Adbo03/Projet_Arduinode/ADXL_SPI.ino

#include <NimBLEDevice.h>
#include <SPI.h>
#include "SdFat.h"
#include <TinyGPS++.h>
#include <math.h>
#include <stdlib.h>
#include <map>
#include <WiFi.h>
#include <WebServer.h>
#include <esp_now.h>
#include <set>

#define ON              1
#define OFF             0

// Paramétrage
#define ADXL_CS         10
#define SD_CS           9 
#define SCK_SD          22
#define MOSI_SD         23
#define MISO_SD         21

#define PPS_PIN         2

// Modes
#define SBY             0
#define LIVE            1
#define RECORD          2
#define WIFI_COLLECT    3

// Plages de mesure
#define _2g             0
#define _4g             1
#define _8g             2

// Frequences d'échantillonnage
#define _4000Hz         0
#define _2000Hz         1
#define _1000Hz         2
#define _500Hz          3
#define _250Hz          4
#define _125Hz          5
#define _62_5Hz         6
#define _31_25Hz        7
#define _15_625Hz       8
#define _7_813Hz        9
#define _3_906Hz        10

// Types de messages ESP NOW
#define CMD_PING        0  
#define CMD_CONFIG      1   
#define REPLY_PONG      2  
#define REPLY_ACK       3  

// Tensions batterie
#define V_MAX           4.2 
#define V_MIN           3.0

// Bus SPI dédié pour communiquer avec le lecteur SD
SPIClass sdSPI(HSPI);

struct Sample_SD {
  int32_t x, y, z;
  uint32_t sub_sec_us; // Microsecondes écoulées depuis le dernier front PPS
};

struct Sample_LIVE {
  int32_t x, y, z;
};

// Gestion de la retransmission des modifications BLE (ESP-NOW)
struct __attribute__((packed)) SyncPacket {
  uint32_t msgId;  
  uint8_t type;        
  uint8_t originMac[6];
  uint8_t mode;      
  uint8_t range;     
  uint8_t frequency; 
  uint32_t nodeID;
  uint8_t batteryLevel;
};

SyncPacket pendingConfig;            
uint32_t lastReceivedMsgId = 0;       
volatile bool hasNewConfigFromESPNow = false; 
uint8_t broadcastAddress[] = {0xFF, 0xFF, 0xFF, 0xFF, 0xFF, 0xFF};

std::set<String> discoveredNodes;  
std::set<String> ackedNodes;       
std::set<String> forwardedReplies; 
volatile bool isInitiator = false;

// Buffers 
const int BUF_SIZE_SD = 32;
Sample_SD bufferSD[2][BUF_SIZE_SD];

const int BUF_SIZE_LIVE = 42; 
Sample_LIVE bufferLIVE[3][BUF_SIZE_LIVE];

volatile int activeBuf = 0;
volatile int bufIdx = 0;
volatile bool fullFlag = false;

SdFat sd;
SdFile file;
TinyGPSPlus gps;
hw_timer_t * timerSample = NULL;

WebServer server(80);

const int tabHz[11] = {4000, 2000, 1000, 500, 250, 125, 62.5, 31.25, 15.625, 7.813, 3.906};
volatile uint8_t currentMode = SBY; 
volatile uint8_t currentRange = _2g;
volatile uint8_t currentFreq = _4000Hz;
volatile uint8_t broadcast = ON;

volatile int32_t TICK_SAMPLE_US = 1000000/tabHz[currentFreq];

volatile uint32_t pps_micros = 0;
float lastLat = 0, lastLon = 0;
char hours[3], minutes[3], seconds[3], interval[3], day[3], month[3], year[5];

// Adresses des registres
const int REG_XDATA3 = 0x08;
const int REG_RANGE  = 0x2C;
const int REG_POWER_CTL = 0x2D;
const int REG_FILTER = 0x28;

// Objets et pointeurs BLE 
NimBLEServer* pServer = NULL;
NimBLECharacteristic* pRawDataChar = NULL;
NimBLECharacteristic* pModeChar = NULL;
NimBLECharacteristic* pRangeChar = NULL;
NimBLECharacteristic* pFrequencyChar = NULL;
NimBLECharacteristic* pBroadcastChar = NULL;
NimBLECharacteristic* pSyncChar = NULL;

volatile bool deviceConnected = false;
bool wasConnected = false;
volatile bool modeWritten = false;
volatile bool rangeWritten = false;
volatile bool freqWritten = false;
volatile bool wifiStarted = false;

int32_t x_raw = 0;
int32_t y_raw = 0;
int32_t z_raw = 0;

SemaphoreHandle_t timerSampleFlag;

uint64_t arduinodeID = 0;
String nodeName = "Arduinode_0";

void configureArduinodeID() {
  uint64_t chipID = ESP.getEfuseMac(); 
  Serial.printf("ID: %04X%08X\n", (uint16_t)(chipID >> 32), (uint32_t)chipID);      
  
  // Utilisation de l'adresse MAC pour générer des identifiants uniques
  if (chipID == 0x4886AE63B0E4) { arduinodeID = 0; }
  else if (chipID == 0x98302E43CA48) { arduinodeID = 1; }
  else if (chipID == 0x2C3CA0BD4D74) { arduinodeID = 2; }
  else { 
    arduinodeID = chipID; 
  }
  
  nodeName = "Arduinode_" + String(arduinodeID);
  Serial.print("Module : "); Serial.println(nodeName);
}


/* - - - Fonctions pour gérer la retransmission aux autres arduinodes - - - */

String macToString(const uint8_t* mac) {
  char buf[20];
  snprintf(buf, sizeof(buf), "%02X:%02X:%02X:%02X:%02X:%02X", mac[0], mac[1], mac[2], mac[3], mac[4], mac[5]);
  return String(buf);
}

void OnDataRecv(const uint8_t * mac, const uint8_t *incomingData, int len) {
  if (len == sizeof(SyncPacket)) {
    SyncPacket packet;
    memcpy(&packet, incomingData, sizeof(SyncPacket));
    String originMacStr = macToString(packet.originMac);

    if (packet.type == CMD_PING || packet.type == CMD_CONFIG) {
      if (packet.msgId > lastReceivedMsgId) {
        lastReceivedMsgId = packet.msgId;
        isInitiator = false;      
        forwardedReplies.clear(); 

        if (packet.type == CMD_CONFIG) {
          pendingConfig = packet;
          hasNewConfigFromESPNow = true;
          Serial.println("Nouvelle configuration reçue !");
        } 
        else {  
          esp_now_send(broadcastAddress, (uint8_t *) &packet, sizeof(packet));
        }

        delayMicroseconds(random(2000, 25000));

        SyncPacket reply;
        reply.msgId = packet.msgId;
        reply.type = (packet.type == CMD_PING) ? REPLY_PONG : REPLY_ACK;
        WiFi.macAddress(reply.originMac);
        reply.mode = currentMode;
        reply.range = currentRange;
        reply.frequency = currentFreq;
        reply.nodeID = (uint32_t)arduinodeID;
        reply.batteryLevel = (uint8_t)getBatteryState();

        esp_now_send(broadcastAddress, (uint8_t *) &reply, sizeof(reply));
      }
    }
    
    else if (packet.type == REPLY_PONG || packet.type == REPLY_ACK) {
      if (packet.msgId == lastReceivedMsgId) {
        
        if (isInitiator) {
          if (packet.type == REPLY_PONG) {

            // Pour éviter des envois redondants
            if(discoveredNodes.insert(originMacStr).second){
              struct __attribute__((packed)) NodeStatusBLE {
                uint32_t nodeID;
                uint8_t batteryLevel;
              } remoteNode;

              remoteNode.nodeID = packet.nodeID;
              remoteNode.batteryLevel = packet.batteryLevel;

              pSyncChar->setValue((uint8_t*)&remoteNode, sizeof(remoteNode));
              pSyncChar->notify();
            }

          } 
          else if (packet.type == REPLY_ACK) {
            
            // Pour éviter des envois redondants
            if(ackedNodes.insert(originMacStr).second){
              if (discoveredNodes.size() > 0 && discoveredNodes.size() == ackedNodes.size()) {
                uint8_t successCode = 0xFF;
                pSyncChar->setValue(&successCode, 1);
                pSyncChar->notify();
              }
            }

          }
        }

        if (forwardedReplies.find(originMacStr) == forwardedReplies.end()) {
          forwardedReplies.insert(originMacStr);
          esp_now_send(broadcastAddress, (uint8_t *) &packet, sizeof(packet));
        }
      }
    }
  }
}

void broadcastConfiguration(uint8_t type, uint8_t mode, uint8_t range, uint8_t freq) {
  lastReceivedMsgId++; 
  isInitiator = true; 
  
  if (type == CMD_PING) {
    discoveredNodes.clear();
    ackedNodes.clear();
  } 
  
  else if (type == CMD_CONFIG) {
    ackedNodes.clear();
  }

  forwardedReplies.clear();

  SyncPacket packet;
  packet.msgId = lastReceivedMsgId;
  packet.type = type;
  WiFi.macAddress(packet.originMac);
  packet.mode = mode;
  packet.range = range;
  packet.frequency = freq;

  esp_now_send(broadcastAddress, (uint8_t *) &packet, sizeof(packet));
}

void initEspNow() {
  WiFi.mode(WIFI_STA);

  if (esp_now_init() != ESP_OK) {
    Serial.println("Erreur : echec de l'initialisation de ESP-NOW");
    return;
  }

  esp_now_register_recv_cb(OnDataRecv);

  esp_now_peer_info_t peerInfo;
  memset(&peerInfo, 0, sizeof(peerInfo));
  memcpy(peerInfo.peer_addr, broadcastAddress, 6);
  peerInfo.channel = 0;  // Canal WiFi par défaut
  peerInfo.encrypt = false;
  
  if (esp_now_add_peer(&peerInfo) != ESP_OK){
    Serial.println("Erreur : echec de l'ajout du peer broadcast");
  } else {
    Serial.println("ESP-NOW configuré et prêt pour la communication inter-arduinodes");
  }
}

/* - - - Fonctions callbacks pour gérer les intéractions avec l'IHM BLE - - - */

class MyServerCallbacks: public NimBLEServerCallbacks {
  public:
    void onConnect(NimBLEServer* pServer, NimBLEConnInfo& connInfo){
      deviceConnected = true;
      // Paramètres : Handle, Min Interval, Max Interval, Latency, Timeout
      pServer->updateConnParams(connInfo.getConnHandle(), 6, 12, 0, 400);
    }
    void onDisconnect(NimBLEServer* pServer, NimBLEConnInfo& connInfo, int reason){
      deviceConnected = false;
    }
};

class ModeCallbacks: public NimBLECharacteristicCallbacks {
    public:
      void onWrite(NimBLECharacteristic* pCharacteristic, NimBLEConnInfo& connInfo) {
        std::string value = pCharacteristic->getValue();
        if (value.length() > 0) {
      
          if(currentMode != (uint8_t)value[0]){
            currentMode = (uint8_t)value[0];
            modeWritten = true;

            if(broadcast) broadcastConfiguration(CMD_CONFIG, currentMode, currentRange, currentFreq);
          }

          else{
            modeWritten = false;
          }

        }
      }
};

class RangeCallbacks: public NimBLECharacteristicCallbacks {
    public:
      void onWrite(NimBLECharacteristic* pCharacteristic, NimBLEConnInfo& connInfo) {
        std::string value = pCharacteristic->getValue();
        if (value.length() > 0) {

          if(currentRange != (uint8_t)value[0]){
            currentRange = (uint8_t)value[0];
            rangeWritten = true;
            
            if(broadcast) broadcastConfiguration(CMD_CONFIG, currentMode, currentRange, currentFreq);
          }

          else{
            rangeWritten = false;
          }

        }
      }
};

class FreqCallbacks: public NimBLECharacteristicCallbacks {
    public:
      void onWrite(NimBLECharacteristic* pCharacteristic, NimBLEConnInfo& connInfo) {
        std::string value = pCharacteristic->getValue();
        if (value.length() > 0) {
      
          if(currentFreq != (uint8_t)value[0]){
            currentFreq = (uint8_t)value[0];
            freqWritten = true;

            if(broadcast) broadcastConfiguration(CMD_CONFIG, currentMode, currentRange, currentFreq);
          }

          else{
            freqWritten = false;
          }

        }
      }
};

class BroadcastCallbacks: public NimBLECharacteristicCallbacks {
    public:
      void onWrite(NimBLECharacteristic* pCharacteristic, NimBLEConnInfo& connInfo) {
        std::string value = pCharacteristic->getValue();

        if (value.length() > 0){
          broadcast = (uint8_t)value[0];
          pBroadcastChar->setValue((uint8_t*) &broadcast, (size_t) sizeof(broadcast));
        }
      }
};

class SyncCallbacks: public NimBLECharacteristicCallbacks {
    public:
      void onWrite(NimBLECharacteristic* pCharacteristic, NimBLEConnInfo& connInfo) {
        std::string value = pCharacteristic->getValue();
        if (value.length() > 0 && value[0] == 1) {
          struct __attribute__((packed)) NodeStatusBLE {
            uint32_t nodeID;
            uint8_t batteryLevel;
          } localNode;

          localNode.nodeID = (uint32_t)arduinodeID;
          localNode.batteryLevel = (uint8_t)getBatteryState();

          pSyncChar->setValue((uint8_t*)&localNode, sizeof(localNode));
          pSyncChar->notify();

          if(broadcast) broadcastConfiguration(CMD_PING, currentMode, currentRange, currentFreq);
        }
      }
};

/* - - - Gestionnaires d'interruptions - - - */

void IRAM_ATTR Sample_handler() {
  BaseType_t xHigherPriorityTaskWoken = pdFALSE;
  xSemaphoreGiveFromISR(timerSampleFlag, &xHigherPriorityTaskWoken);
  if (xHigherPriorityTaskWoken) {
    portYIELD_FROM_ISR();
  }
}

void IRAM_ATTR PPS_handler() {
  pps_micros = micros(); 
}

/* - - - Lecture et formattage des données de l'ADXL - - - */

void ADXL_ReadRaw(){
  if((currentMode == LIVE) || (currentMode == RECORD)){
    // 10MHz, Mode 0 (CPOL=0, CPHA=0)
    SPI.beginTransaction(SPISettings(10000000, MSBFIRST, SPI_MODE0));
    
    // Lecture de XDATA3 (9 octets)
    digitalWrite(ADXL_CS, LOW);
    SPI.transfer((REG_XDATA3 << 1) | 0x01); 
    
    uint32_t x3 = SPI.transfer(0x00);
    uint32_t x2 = SPI.transfer(0x00);
    uint32_t x1 = SPI.transfer(0x00);
    
    uint32_t y3 = SPI.transfer(0x00);
    uint32_t y2 = SPI.transfer(0x00);
    uint32_t y1 = SPI.transfer(0x00);
    
    uint32_t z3 = SPI.transfer(0x00);
    uint32_t z2 = SPI.transfer(0x00);
    uint32_t z1 = SPI.transfer(0x00);

    digitalWrite(ADXL_CS, HIGH);

    SPI.endTransaction();

    // Reformatage des données
    x_raw = (x3 << 12) | (x2 << 4) | (x1 >> 4);
    y_raw = (y3 << 12) | (y2 << 4) | (y1 >> 4);
    z_raw = (z3 << 12) | (z2 << 4) | (z1 >> 4);

    if (x_raw & 0x00080000) x_raw |= 0xFFF00000;
    if (y_raw & 0x00080000) y_raw |= 0xFFF00000;
    if (z_raw & 0x00080000) z_raw |= 0xFFF00000;
  }
}

void ADXL_Task(void * pvParameters) {
  while(1) {
    if (xSemaphoreTake(timerSampleFlag, portMAX_DELAY) == pdTRUE) {
      ADXL_ReadRaw();

      if(currentMode == LIVE){
        bufferLIVE[activeBuf][bufIdx] = {x_raw, y_raw, z_raw};
        bufIdx++;

        // taille du paquet proportionnel à la fréquence
        if (bufIdx >= (BUF_SIZE_LIVE >> currentFreq)) {
          bufIdx = 0;
          activeBuf = (activeBuf + 1) % 3;
          fullFlag = true;
        }
      }

      else if (currentMode == RECORD){
        uint32_t current_micros = micros();
        uint32_t offset_us = current_micros - pps_micros;

        bufferSD[activeBuf][bufIdx] = {x_raw, y_raw, z_raw, offset_us};
        bufIdx++;

        if (bufIdx >= BUF_SIZE_SD) {
          bufIdx = 0;
          activeBuf = (activeBuf == 0) ? 1 : 0;
          fullFlag = true;
        }
      }
    }
  }
}

void writeRegister(uint8_t reg, uint8_t value) {
  digitalWrite(ADXL_CS, LOW);
  SPI.transfer((reg << 1) | 0x00);
  SPI.transfer(value);
  digitalWrite(ADXL_CS, HIGH);
}

/* - - - Fonctions de configuration et de gestion pour l'envoi des données en WIFI - - - */

void handleListFiles() {
  String fileList = "";
  FsFile root;
  FsFile file;
  
  if (!root.open("/")) {
    server.send(500, "text/plain", "Erreur : Impossible d'ouvrir la racine SD");
    return;
  }

  while (file.openNext(&root, O_RDONLY)) {
    char name[100];
    file.getName(name, sizeof(name));
    
    if (!file.isDir()) {
      String filename = String(name);
      
      if (filename.endsWith(".bin")) {
        fileList += filename + "\n";
      }
    }
    file.close(); 
  }

  root.close();
  server.send(200, "text/plain", fileList);
}

void handleDownloadFile() {
  if (!server.hasArg("name")) {
    server.send(400, "text/plain", "Missing 'name' parameter");
    return;
  }
  String filename = server.arg("name");
  if (!filename.startsWith("/")) filename = "/" + filename;

  FsFile dataFile;

  if (dataFile.open(filename.c_str(), O_RDONLY)) {
    uint64_t fileSize = dataFile.size();
    
    server.setContentLength(fileSize);
    server.send(200, "application/octet-stream", "");

    // Envoi du contenu du fichier binaire par blocs (Buffer)
    uint8_t buffer[512]; 
    while (dataFile.available()) {
      int bytesRead = dataFile.read(buffer, sizeof(buffer));
      if (bytesRead > 0) {
        server.client().write(buffer, bytesRead);
      }
    }

    dataFile.close();
  }
  else {
    server.send(404, "text/plain", "File not found");
  }
}

void handleDeleteFile() {
  if (!server.hasArg("name")) {
    server.send(400, "text/plain", "Missing 'name' parameter");
    return;
  }
  String filename = server.arg("name");
  if (!filename.startsWith("/")) filename = "/" + filename;

  if (sd.exists(filename.c_str())) {
    if (sd.remove(filename.c_str())) {
      server.send(200, "text/plain", "DONE : File removed");
    } 
    else {
      server.send(500, "text/plain", "Error : File failed to be erased");
    }
  } 
  
  else { server.send(404, "text/plain", "File not found");}
}

void handleReboot() {
  server.send(200, "text/plain", "Rebooting...");
  delay(500);
  ESP.restart();
}

void setupWiFiAndServer() {
  String ssid = nodeName + "_WIFI";

  WiFi.softAP(ssid.c_str(), "password123");
  
  server.on("/list", HTTP_GET, handleListFiles);
  server.on("/download", HTTP_GET, handleDownloadFile);
  server.on("/delete", HTTP_GET, handleDeleteFile);
  server.on("/reboot", HTTP_GET, handleReboot);
  
  server.begin();
}

float getBatteryState() {
  int adcValue = analogRead(A0);
  float vMeasured = (adcValue * 3.3) / 4095.0;
  float vBat = vMeasured * 3/2;
  float percentage = ((vBat - V_MIN) / (V_MAX - V_MIN)) * 100.0;
  
  if (percentage > 100.0) percentage = 100.0;
  if (percentage < 0.0) percentage = 0.0;
  
  Serial.print("Tension brute mesurée (A0) : ");
  Serial.print(vMeasured);
  Serial.print(" V | Tension Batterie : ");
  Serial.print(vBat);
  Serial.print(" V | Niveau restant : ");
  Serial.print(percentage, 1);
  Serial.println(" %");

  return percentage;
}

/* - - - Configuration globale du système - - - */
void setup() {
  Serial.begin(115200);
  Serial1.begin(9600, SERIAL_8N1, D0, D1); // UART GPS
  delay(1000); 

  // Configuration de la fréquence du module GPS à 10 Hz
  Serial1.println("$PMTK220,100*2F");

  Serial1.println("$PMTK314,0,1,0,1,0,0,0,0,0,0,0,0,0,0,0,0,0,0,0*28");

  Serial.println("--- DEMARRAGE DU SYSTEME ---");

  pinMode(ADXL_CS, OUTPUT);
  pinMode(SD_CS, OUTPUT);

  digitalWrite(ADXL_CS, HIGH);
  digitalWrite(SD_CS, HIGH);

  SPI.begin();
  sdSPI.begin(SCK_SD, MISO_SD, MOSI_SD, SD_CS);

  Serial.println("Bus SPI initialise.\nTentative initialisation SD...");
  
  if (!sd.begin(SdSpiConfig(SD_CS, DEDICATED_SPI, SD_SCK_MHZ(10), &sdSPI))) {
      Serial.println("Erreur Carte SD !");
      sd.initErrorPrint(&Serial); 
      while(1);
  }

  timerSampleFlag = xSemaphoreCreateBinary();
  
  xTaskCreatePinnedToCore(ADXL_Task, "ADXL_Task", 4096, NULL, 10, NULL, 1);

  delay(500);

  configureArduinodeID();
  initEspNow();

  // Configuration BLE 
  NimBLEDevice::init(nodeName.c_str());
  NimBLEDevice::setMTU(512); 

  pServer = NimBLEDevice::createServer();
  pServer->setCallbacks(new MyServerCallbacks());

  NimBLEService* pService = pServer->createService("19b10000-e8f2-537e-4f6c-d104768a1214");

  pRawDataChar = pService->createCharacteristic(
                   "19b10001-e8f2-537e-4f6c-d104768a1214",
                   NIMBLE_PROPERTY::READ | NIMBLE_PROPERTY::NOTIFY
                 );

  pModeChar = pService->createCharacteristic(
                "19b10002-e8f2-537e-4f6c-d104768a1214",
                NIMBLE_PROPERTY::READ | NIMBLE_PROPERTY::WRITE
              );
  
  pRangeChar = pService->createCharacteristic(
                "19b10003-e8f2-537e-4f6c-d104768a1214",
                NIMBLE_PROPERTY::READ | NIMBLE_PROPERTY::WRITE
              );

  pFrequencyChar = pService->createCharacteristic(
                "19b10004-e8f2-537e-4f6c-d104768a1214",
                NIMBLE_PROPERTY::READ | NIMBLE_PROPERTY::WRITE
              );

  pBroadcastChar = pService->createCharacteristic(
                "19b10005-e8f2-537e-4f6c-d104768a1214",
                NIMBLE_PROPERTY::READ | NIMBLE_PROPERTY::WRITE
              );

  pSyncChar = pService->createCharacteristic(
                "19b10006-e8f2-537e-4f6c-d104768a1214",
                NIMBLE_PROPERTY::READ | NIMBLE_PROPERTY::WRITE | NIMBLE_PROPERTY::NOTIFY
              );

  pModeChar->setCallbacks(new ModeCallbacks());
  pRangeChar->setCallbacks(new RangeCallbacks());
  pFrequencyChar->setCallbacks(new FreqCallbacks());
  pBroadcastChar->setCallbacks(new BroadcastCallbacks());
  pSyncChar->setCallbacks(new SyncCallbacks());

  pService->start();

  NimBLEAdvertising* pAdvertising = NimBLEDevice::getAdvertising();
  pAdvertising->addServiceUUID(pService->getUUID());
  pAdvertising->setName("Arduinode");
  pAdvertising->setPreferredParams(0x06, 0x12); 
  pAdvertising->start();
  
  Serial.println("Configuration BLE terminée.");

  // Configuration de la précision de l'accéléromètre (2g)
  writeRegister(REG_RANGE, 0x01); 
  writeRegister(REG_POWER_CTL, 0x00);

  // Timer pour l'acquisition des données
  timerSample = timerBegin(0, 80, true);
  timerAttachInterrupt(timerSample, &Sample_handler, true);
  timerAlarmWrite(timerSample, TICK_SAMPLE_US, true);
  timerAlarmEnable(timerSample);

  // Configuration de PPS_PIN
  pinMode(PPS_PIN, INPUT_PULLDOWN);
  attachInterrupt(digitalPinToInterrupt(PPS_PIN), PPS_handler, RISING);

  if (!file.open("init.bin", O_RDWR | O_CREAT | O_AT_END)) {
    Serial.println("Echec critique : impossible de créer le fichier binaire.");
  }
  file.remove();
  file.close();

  delay(1000);

  pModeChar->setValue((uint8_t*) &currentMode, (size_t) sizeof(currentMode));
  pRangeChar->setValue((uint8_t*) &currentRange, (size_t) sizeof(currentRange));
  pFrequencyChar->setValue((uint8_t*) &currentFreq, (size_t) sizeof(currentFreq));
  pBroadcastChar->setValue((uint8_t*) &broadcast, (size_t) sizeof(broadcast));

  Serial.println("Système prêt.");
}

void loop() {

  /* - - - Synchronisation inter-arduinodes (ESP-NOW) - - - */
  if (hasNewConfigFromESPNow) {
    hasNewConfigFromESPNow = false; 
    lastReceivedMsgId = pendingConfig.msgId; 

    if(currentMode != pendingConfig.mode){
      modeWritten = true;

      // Inutile de mettre les arduinodes non connectées à l'IHM en mode LIVE
      if(pendingConfig.mode == LIVE){
        currentMode = SBY;
      }
      else{
        currentMode = pendingConfig.mode;
      }
    }

    if(currentRange != pendingConfig.range){
      rangeWritten = true;
      currentRange = pendingConfig.range;
    }

    if(currentFreq != pendingConfig.frequency){
      freqWritten = true;
      currentFreq = pendingConfig.frequency;
    }

    esp_now_send(broadcastAddress, (uint8_t *) &pendingConfig, sizeof(pendingConfig));
  }


  /* - - - Mise à jour des modes et paramètres - - - */
  
  if(modeWritten){
    modeWritten = false;
    
    pModeChar->setValue((uint8_t*) &currentMode, (size_t) sizeof(currentMode));

    timerAlarmDisable(timerSample);

    activeBuf = 0;
    bufIdx = 0;
    fullFlag = false;

    if(file.isOpen()) 
      file.close();

    if(currentMode == LIVE) Serial.println("Début du stream...");
    
    
    else if(currentMode == RECORD){

      Serial.println("Début du stockage des données...");

      if (!file.isOpen()) {

        unsigned long startAttempt = millis();
        bool gpsFound = false;

        // Récupération des données GPS
        while (millis() - startAttempt < 5000) {
          while (Serial1.available() > 0) {
            if (gps.encode(Serial1.read())) {
              if (gps.location.isValid() && gps.time.isValid() && gps.date.isValid()) {
                lastLat = gps.location.lat();
                lastLon = gps.location.lng();
                gpsFound = true;
                break;
              }
            }
          }
          if (gpsFound) break;
        }

        snprintf(day, sizeof(day), "%02d", gps.date.day());
        snprintf(month, sizeof(month), "%02d", gps.date.month());
        snprintf(year, sizeof(year), "%04d", gps.date.year());

        snprintf(hours, sizeof(hours), "%02d", gps.time.hour());
        snprintf(minutes, sizeof(minutes), "%02d", gps.time.minute());
        snprintf(seconds, sizeof(seconds),"%02d", gps.time.second());


        if(currentRange == _2g) sprintf(interval, "2g");
        else if(currentRange == _4g) sprintf(interval, "4g");
        else if(currentRange == _8g) sprintf(interval, "8g");

        char title[sizeof(nodeName) + sizeof(hours) + sizeof(minutes) + sizeof(seconds) + sizeof(interval) + 12];

        snprintf(title, sizeof(title), "%s_%s_%s_%s_UTC_%s.bin", nodeName, hours, minutes, seconds, interval);

        if (!file.open(title, O_RDWR | O_CREAT | O_AT_END)) {
          Serial.println("Echec critique : impossible de créer le fichier binaire.");
        }
        
        else{
        
          file.print("GPS:"); 
          file.print(lastLat, 6); 
          file.print(","); 
          file.print(lastLon, 6);
          file.print(",");

          file.print(hours);
          file.print(':');
          file.print(minutes);
          file.print(':');
          file.print(seconds);
          file.print(",");

          file.print(interval);
          file.print(",");
          
          file.print(day);
          file.print('/');
          file.print(month);
          file.print('/');
          file.print(year);

          file.println(); 
        }
      }
    }

    else if(currentMode == WIFI_COLLECT){
      // Passage du BLE au WiFi
      NimBLEDevice::deinit(true); 
      delay(200);
      wifiStarted = false;
    }

    timerAlarmEnable(timerSample);
  }

  if(rangeWritten){
    rangeWritten = false;
    
    pRangeChar->setValue((uint8_t*) &currentRange, (size_t) sizeof(currentRange));

    timerAlarmDisable(timerSample);

    if(currentRange == _2g){
      writeRegister(REG_POWER_CTL, 0x01);
      writeRegister(REG_RANGE, 0x01); 
      writeRegister(REG_POWER_CTL, 0x00);
    }

    else if(currentRange == _4g){
      writeRegister(REG_POWER_CTL, 0x01);
      writeRegister(REG_RANGE, 0x02); 
      writeRegister(REG_POWER_CTL, 0x00);
    }

    else if(currentRange == _8g){
      writeRegister(REG_POWER_CTL, 0x01);
      writeRegister(REG_RANGE, 0x03); 
      writeRegister(REG_POWER_CTL, 0x00);
    }
    
    timerAlarmEnable(timerSample);
  }

  if(freqWritten){
    freqWritten = false;
    
    pFrequencyChar->setValue((uint8_t*) &currentFreq, (size_t) sizeof(currentFreq));

    timerAlarmDisable(timerSample);

    if(currentFreq == _4000Hz){
      writeRegister(REG_POWER_CTL, 0x01);
      writeRegister(REG_FILTER, 0x00); 
      writeRegister(REG_POWER_CTL, 0x00);
    }

    else if(currentFreq == _2000Hz){
      writeRegister(REG_POWER_CTL, 0x01);
      writeRegister(REG_FILTER, 0x01); 
      writeRegister(REG_POWER_CTL, 0x00);
    }

    else if(currentFreq == _1000Hz){
      writeRegister(REG_POWER_CTL, 0x01);
      writeRegister(REG_FILTER, 0x02); 
      writeRegister(REG_POWER_CTL, 0x00);
    }

    else if(currentFreq == _500Hz){
      writeRegister(REG_POWER_CTL, 0x01);
      writeRegister(REG_FILTER, 0x03); 
      writeRegister(REG_POWER_CTL, 0x00);
    }

    else if(currentFreq == _250Hz){
      writeRegister(REG_POWER_CTL, 0x01);
      writeRegister(REG_FILTER, 0x04); 
      writeRegister(REG_POWER_CTL, 0x00);
    }

    else if(currentFreq == _125Hz){
      writeRegister(REG_POWER_CTL, 0x01);
      writeRegister(REG_FILTER, 0x05); 
      writeRegister(REG_POWER_CTL, 0x00);
    }

    else if(currentFreq == _62_5Hz){
      writeRegister(REG_POWER_CTL, 0x01);
      writeRegister(REG_FILTER, 0x06); 
      writeRegister(REG_POWER_CTL, 0x00);
    }

    else if(currentFreq == _31_25Hz){
      writeRegister(REG_POWER_CTL, 0x01);
      writeRegister(REG_FILTER, 0x07); 
      writeRegister(REG_POWER_CTL, 0x00);
    }

    else if(currentFreq == _15_625Hz){
      writeRegister(REG_POWER_CTL, 0x01);
      writeRegister(REG_FILTER, 0x08); 
      writeRegister(REG_POWER_CTL, 0x00);
    }

    else if(currentFreq == _7_813Hz){
      writeRegister(REG_POWER_CTL, 0x01);
      writeRegister(REG_FILTER, 0x09); 
      writeRegister(REG_POWER_CTL, 0x00);
    }

    else if(currentFreq == _3_906Hz){
      writeRegister(REG_POWER_CTL, 0x01);
      writeRegister(REG_FILTER, 0x0A); 
      writeRegister(REG_POWER_CTL, 0x00);
    }

    TICK_SAMPLE_US = 1000000/tabHz[currentFreq];

    timerAlarmWrite(timerSample, TICK_SAMPLE_US, true);
    timerAlarmEnable(timerSample);
  }

  /* - - - Envoi des données en BLE en mode LIVE - - - */
  if(currentMode == LIVE && fullFlag){ 
    int bufToSave = (activeBuf == 0) ? 2 : activeBuf - 1;
    fullFlag = false;

    uint8_t* ptrBuf = (uint8_t*) bufferLIVE[bufToSave];

    pRawDataChar->setValue(ptrBuf, std::max(1, (int) (BUF_SIZE_LIVE >> currentFreq))*12);
    pRawDataChar->notify();
  }
  

  /* - - - Sauvegarde SD en mode RECORD - - - */
  else if(currentMode == RECORD && fullFlag){
    int bufToSave = (activeBuf == 0) ? 1 : 0;
    
    if(file.isOpen()){
      file.write((const uint8_t*)&bufferSD[bufToSave], sizeof(bufferSD[0]));
      fullFlag = false;
    }

  }

  /* - - - Envoi en WIFI des données SD - - - */
  else if(currentMode == WIFI_COLLECT){

    if(!wifiStarted){
      setupWiFiAndServer();
      wifiStarted = true;
      delay(500);
    }

    server.handleClient();
  }

  /* - - - Gestion automatique de la reconnexion - - - */
  if (!deviceConnected && wasConnected && currentMode != WIFI_COLLECT) {
    delay(500); 
    NimBLEDevice::startAdvertising();
    wasConnected = false;

    // Arrêt des envois BLE
    if(currentMode == LIVE){
      currentMode = SBY;
      pModeChar->setValue((uint8_t*) &currentMode, (size_t) sizeof(currentMode));
    }

  }

  if (deviceConnected && !wasConnected) {
    wasConnected = true;
  }
}
