Adbo03/Projet_Arduinode/(commit log)

2026-04-30 Code simple pour tester l'ADXL et recevoir des données affichées sur IDE Arduino
2026-05-04 Code pour afficher les données d'un ADXL355Z en SPI
2026-05-04 Code pour afficher les données d'un ADXL355Z en I2C
2026-05-04 Mise en place du BLE pour transmettre les données de l'accéléromètre. Configuration du BLE et du protocole SPI réussis.
2026-05-05 Modification du code pour lire les données des 3 composantes de l'ADXL afin de pouvoir les partager en BLE (+ suppression du fichier Test_simple_ADXL qui a servi de base au code ADXL_I2C)
2026-05-05 Suppression du code gérant l'allumage à distance de la LED interne. Il s'agissait du code qui a servi de base pour implémenter la communication BLE.
2026-05-05 Configuration des chracteristics pour permettre les notifications
2026-05-05 Ajout de SERVEUR_ADXL qui permet de collecter les 10 valeurs les plus récentes pour les 3 composantes X Y Z et de stockées ces dernières dans un tableau 'adxl355_data.csv'. L'idée est d'automatiser l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
2026-05-05 Modifications pour afficher directement les données reçues sur un graphe en utilisant le buffer (plus besoin du fichier csv pour stocker les données)
2026-05-05 Suppression du warning de la ligne 91 + déconnection avec la Nano ESP32 lorsque la fenêtre est fermée
2026-05-05 Ajout de l'inclinaison sur les axes X et Y.
2026-05-06 Enhance README with project details and usage instructions
    Added detailed project description, components used, usage instructions, and connection protocols for I2C and SPI.
2026-05-07 Ajout d'une interface pour choisir entre differents modes de fonctionnement : visualisation en direct, sauvegarde sur carte SD ou lecture de données depuis la carte SD
2026-05-07 Refactor ADXL_SPI for SD card support and mode handling
    Updated SPI configuration and added SD card functionality for data logging. Implemented mode switching for streaming and recording data.
2026-05-07 Ajout d'une interface pour sélectionner le mode de fonctionnement
    Added functionality for mode selection and buffer clearing.
2026-05-11 Mofication de l'affichage de la rotation de l'accéléromètre sur les axes X et Y. Passage en format texte.
2026-05-11 Mise à jour de la liste des composants utilisés
2026-05-12 Ajout des instructions de cablage pour le lecteur SD et le module GPS
2026-05-13 programme permettant de convertir le fichier binaire stocké dans la carte SD du Node en un fichier csv exploitable
2026-05-13 Traduction en anglais des entêtes du tableau csv en sortie
2026-05-18 Capture du temps UTC et de la position géographique
2026-05-18 Ajout des connexions pour le PPS du module GPS
2026-05-18 Calcul du temps a la microseconde près avec le PPS du module GPS afin de permettre par la suite une meilleure analyse des données et une potentielle synchronisation entre plusieurs systèmes identiques
2026-05-18 Ajout du calcul des minutes et des heures
2026-05-18 Ajout d'un bus SPI dédié au lecteur SD dans ADXL_SPI.ino + Modification des paramètres d'affichages pour un meilleur rendu dans SERVEUR_ADXL.py
2026-05-18 Modification des connexions entre le lecteur SD et la nano pour donner au lecteur SD son propre bus SPI
2026-05-19 Reconnexion automatique avec la carte lorsque le communication a été interrompue. Le programme s'arrête seulement si la fenêtre est fermée.
2026-05-19 Suppression du mode pour convertir directement le fichier binaire en csv depuis la carte. Il est plus adapté de convertir le fichier sur l'ordinateur.
2026-05-19 Suppression du mode de conversion sur l'UI + agrandissement de la fenêtre de visualisation à 4000 échantillons par frame
2026-05-21 Changement de la bibliothèque BLE pour utiliser NimBLE afin de configurer le MTU + amélioration de la précision en mode LIVE (4000 échantillons/sec) + renommage des fichiers de sauvegarde avec le tem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
2026-05-21 Mofications pour convertir automatiquement tous les fichiers binaires présents sur la carte SD en CSV, les stocker (.bin et .csv) sur l'ordinateur et les supprimer de la carte SD pour libérer le stoc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
2026-05-26 Correction du bug à l'initialisation pour le mode LIVE
    [ADXL_SPI.ino]
2026-05-27 Modifications afin de permettre le paramétrage de la plage de mesure
2026-05-27 Modifications pour pouvoir sélectionner le type de sauvegarde souhaité (en lien avec SERVEUR_ADXL)
2026-05-27 Modification pour pouvoir paramétrer la plage de mesure ainsi que le type de sauvagarde + ajout d'un bouton pour mettre en pause la connection BLE (lors de la conversion des fichiers par exemple)
2026-05-27 Modification afin de pouvoir paramétrer la fréquence d'échantillonnage de l'accéléromètre
2026-05-27 Amélioration de la desactivation BLE via l'interface pour mettre en pause l'abonnement aux données de l'accéléromètre
2026-05-27 Exécutable permettant de lancer l'interface plus facilement (fonctionne seulement sur Windows)
2026-05-27 Ajout de la discription des fichiers CONVERSION_BIN_CSV.py et ScanEarth.exe
2026-05-27 Ajustement des axes en fonction de la frequence d'échantillonnage
2026-05-27 Changement de l'axe des abscisses pour un passage à un axe temporel
2026-05-27 Ajout des instructions pour générer l'exécutable avec pyinstaller
2026-05-27 Correction faute de frappe
2026-05-27 Lors de la connexion avec la carte, on vient initialiser les paramètres cêté code python avec les valeurs actuelles de la carte.
2026-05-29 Amélioration de l'interface + ajout de nouvelles fréquences d'échantillonnages
2026-06-10 Changement du mode de sauvegarde par défaut lors de l'extraction des données sur le PC
2026-06-10 Correction des calculs d'inclinaison
    [SERVEUR_ADXL.py]
2026-06-11 Correction dans la méthode pour calculer le temps
    [CONVERSION_BIN_CSV.py]
2026-06-12 Modification de l'interface pour paramétrer la fréquence de la source et activer cette dernière
2026-06-12 Ajout de la possibilité de piloter la source de vibration
    [ADXL_SPI.ino]
2026-06-18 Mise à jour complète de la fenêtre du graphe lorsqu'on change d'échelle (zoom) pour éviter d'avoir des résidus de courbes
2026-06-19 Implémentation de la source de vibration dans un fichier à part pour ne pas aloudir le fichier principal et assurer des fréquences de vibrations correctes. Centralisation du contrôle de la source et 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
    [SERVEUR_ADXL.py, SOURCE_BLE.ino]
2026-06-19 Recherche des cartes avec les UUID des services
2026-06-24 Modifications dans l'interface et dans le code arduino pour générer un ricker en guise de source.
2026-06-24 Suppression des parties concernant la génération de la source
2026-06-24 Ajout des informations pour mettre en place la source
2026-06-26 Ajout d'un mode STANDBY pour limiter l'envoi de données en BLE + Suppression de la connexion automatique à la source
2026-06-29 Détection automatique de la carte SD pour contrer les changements de chemins d'accès
2026-06-30 Code pour permettre la collecte des données de l'arduinode en WiFi. Cela évite de devoir récupérer la carte SD pour extraire les données.
2026-06-30 Ajout d'un nouveau mode pour permettre la collecte de données en WiFi + Traitement de ces données en utilisant le code de DATA_COLLECT_WIFI.py
2026-07-01 Implémentation de la communication inter-arduinodes pour synchroniser le changement de configuration
2026-07-01 Création de dossiers de sauvegarde propres à chaque arduinode pour une meilleure gestion des données
2026-07-01 Modification du nom des fichiers de sauvegarde pour une meilleure identification de l'arduinode
2026-07-01 Collecte WIFI des données sur plusieurs arduinodes en une seule opération
2026-07-01 Modification pour pouvoir paramétrer la communication entre arduinodes
2026-07-02 Ajout de DATA_COLLECT_WIFI.py
2026-07-13 Ajout d'une logique de recensement afin de détecter les modules déployés et d'obtenir une confirmation de synchronisation entre ces derniers.
2026-07-13 Modification ligne de commande pyinstaller
2026-07-16 Generation d'un nombre fini d'impulsions + automatisation de l'acquisition des données avec la source
2026-07-17 Correction des bugs graphiques
    [SERVEUR_ADXL.py, SOURCE_BLE.ino]
2026-07-17 Mise à jour du guide utilisateur avec les nouvelles fonctionnalités
2026-07-21 Ajout d'incateurs pour mieux synchroniser les arduinodes avec l'interface
2026-07-23 Ajout des projets kicad et des fichiers de fabrication.
2026-07-23 Mise à jour concernant la changement du nombre d'impulsions générées par la source.
2026-07-27 Correction bug d'affichage des mesages de recensement
    [SERVEUR_ADXL.py]
2026-07-27 Désactivation du mode stream lorsque la connexion BLE est interrompue.
2026-07-30 Ajout des liens vers des fournisseurs pour les composants
2026-07-30 Modification de configureArduinodeID()
2026-07-31 Ajout de la date dans les fichiers de sauvegarde.
2026-07-31 Collecte du log de la source + correction bug sur le scan wifi
    [DATA_COLLECT_WIFI.py]
2026-07-31 Modification du callback de la collecte wifi
2026-07-31 Ajustement dynamique de la taille du nom du fichier de sauvegarde pour éviter les overflows.
2026-08-04 Explication détaillée de la procédure pour changer le nom des modules arduinodes
2026-08-04 Ajout de la date pour chaque coup
2026-08-04 Ajout d'une colonne pour la date
2026-08-04 Affichage du niveau de la batterie lors du recensement
2026-08-04 Optimisation de l'affichage lors du recensement
2026-08-07 Correction des bugs liés à la collecte des logs de la source
    [DATA_COLLECT_WIFI.py, SERVEUR_ADXL.py, SOURCE_BLE.ino]
